ktain/GPV1/python/low_light.png

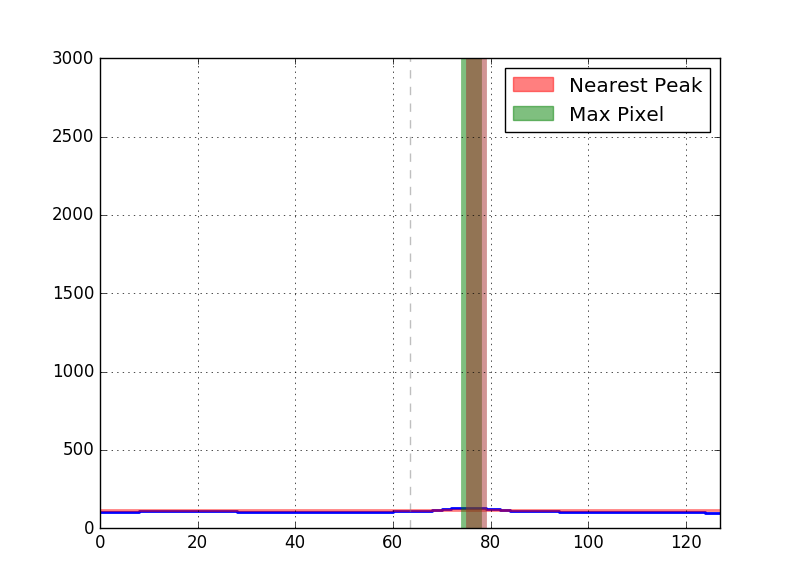
python/low_light.png
