ktain/GPV1/(threads)

Thread 3 (2017-10-20):

TODO: Implement tilt functionality for second camera.

ktain, 2017-10-20:
Remove servo panning functionality and replace with tilt functionality for second camera.

Closed 2017-10-23.

Thread 6 (2017-10-20):

TODO: Low batt indicator

ktain, 2017-10-20:
Need to check battery voltage and warn of low battery.

ktain, 2017-10-21:
Displays battery voltage upon reset.

Closed 2017-10-21.

Thread 7 (2017-10-21):

TODO: Fix camera line scanning interrupt.

ktain, 2017-10-21:
readLine() in TIM3 interrupt is blocking and preventing other interrupts from running.

ktain, 2017-10-21:
Stopped using TIM3 interrupt to read line. Moved read to systick instead.

Closed 2017-10-21.
