ktain/GPV1/eagle/GPV1.brd

## EAGLE design eagle/GPV1.brd (2017-10-25)

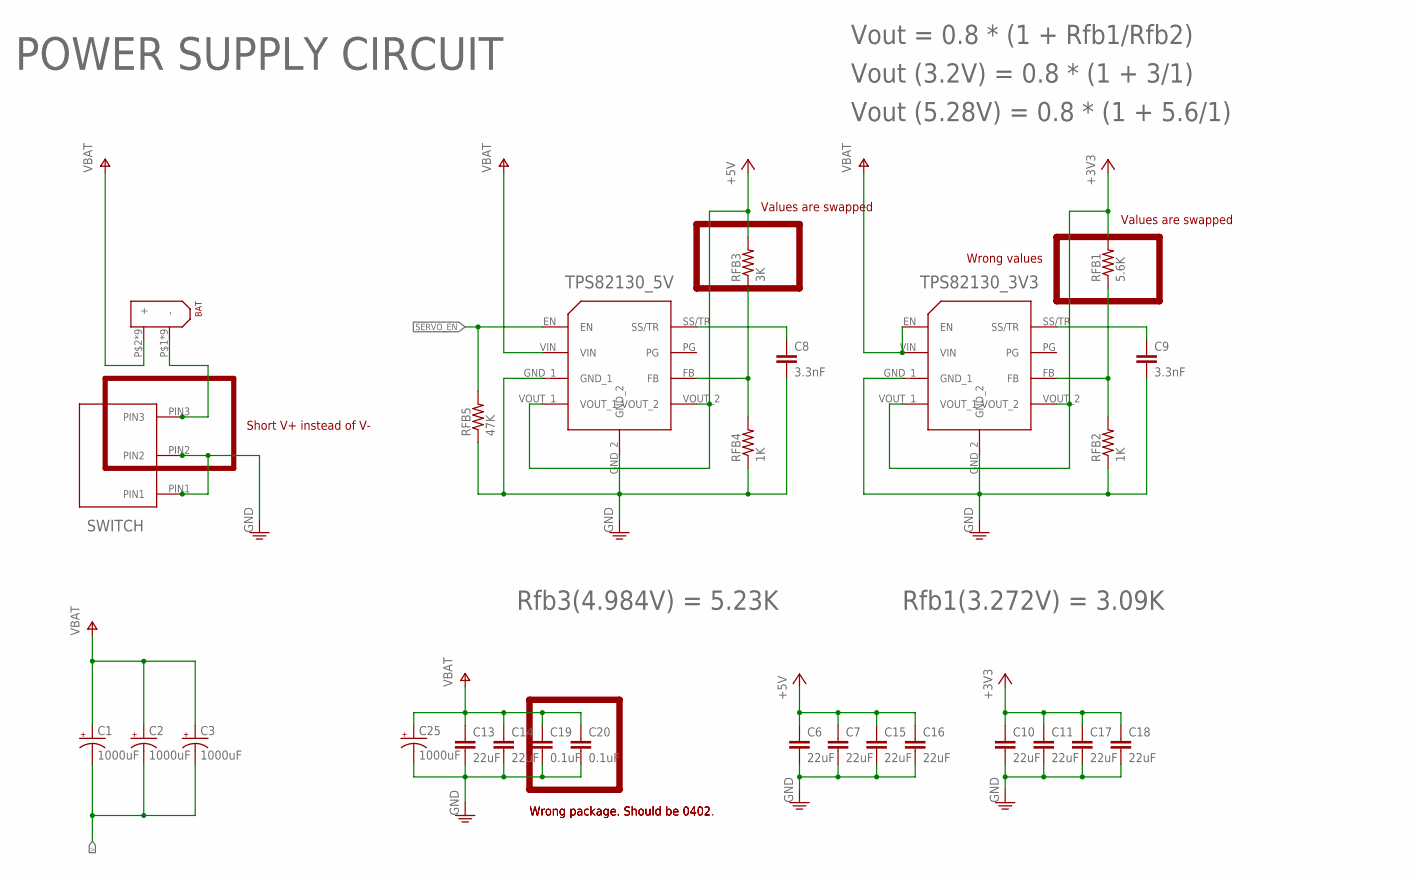
[picture p2: schematic GPV1.sch, sheet 1, Power Supply Circuit]

Parts:
BAT: XT-60
C1, C2, C3, C25: 1000uF; PANASONIC_H13
C6, C7, C10, C11, C13, C14, C15, C16, C17, C18: 22uF; 0805
C8, C9: 3.3nF; 0402-CAP
C19, C20: 0.1uF; 0805
ON<-->OFF: TS02_SWITCH
RFB1: 5.6K; 0402-RES
RFB2, RFB4: 1K; 0402-RES
RFB3: 3K; 0402-RES
RFB5: 47K; 0402-RES
TPS82130_3V3, TPS82130_5V: TPS82130

Connections:
+3V3: C10.1, C11.1, C17.1, C18.1, RFB1.2, TPS82130_3V3.VOUT_1, TPS82130_3V3.VOUT_2; also elsewhere on the board
+5V: C6.1, C7.1, C15.1, C16.1, RFB3.2, TPS82130_5V.VOUT_1, TPS82130_5V.VOUT_2; also elsewhere on the board
GND: C6.2, C7.2, C8.2, C9.2, C10.2, C11.2, C13.2, C14.2, C15.2, C16.2, C17.2, C18.2, C19.2, C20.2, C25.-, ON<-->OFF.PIN1, ON<-->OFF.PIN2, RFB2.1, RFB4.1, RFB5.1, TPS82130_3V3.GND_1, TPS82130_3V3.GND_2, TPS82130_5V.GND_1, TPS82130_5V.GND_2; also elsewhere on the board
unnamed: C9.1, TPS82130_3V3.SS/TR
unnamed: RFB1.1, RFB2.2, TPS82130_3V3.FB
unnamed: C8.1, TPS82130_5V.SS/TR
unnamed: RFB3.1, RFB4.2, TPS82130_5V.FB
SERVO_EN: RFB5.2, TPS82130_5V.EN; also elsewhere on the board
V+: BAT.P$2 (+), BAT.P$7 (+), BAT.P$8 (+), BAT.P$9 (+), BAT.P$10 (+), BAT.P$11 (+), BAT.P$12 (+), BAT.P$13 (+), BAT.P$14 (+), C1.+, C2.+, C3.+, C13.1, C14.1, C19.1, C20.1, C25.+, TPS82130_3V3.EN, TPS82130_3V3.VIN, TPS82130_5V.VIN; also elsewhere on the board
V-: BAT.P$1 (-), BAT.P$3 (-), BAT.P$4 (-), BAT.P$5 (-), BAT.P$6 (-), BAT.P$15 (-), BAT.P$16 (-), BAT.P$17 (-), BAT.P$18 (-), C1.-, C2.-, C3.-, ON<-->OFF.PIN3; also elsewhere on the board

Notes on the sheet:
POWER SUPPLY CIRCUIT
Vout = 0.8 * (1 + Rfb1/Rfb2)
Rfb3(4.984V) = 5.23K
Rfb1(3.272V) = 3.09K
Short V+ instead of V-
Wrong package. Should be 0402
Wrong values
Values are swapped
Wrong package. Should be 0402.
Vout (3.2V) = 0.8 * (1 + 3/1)
Vout (5.28V) = 0.8 * (1 + 5.6/1)

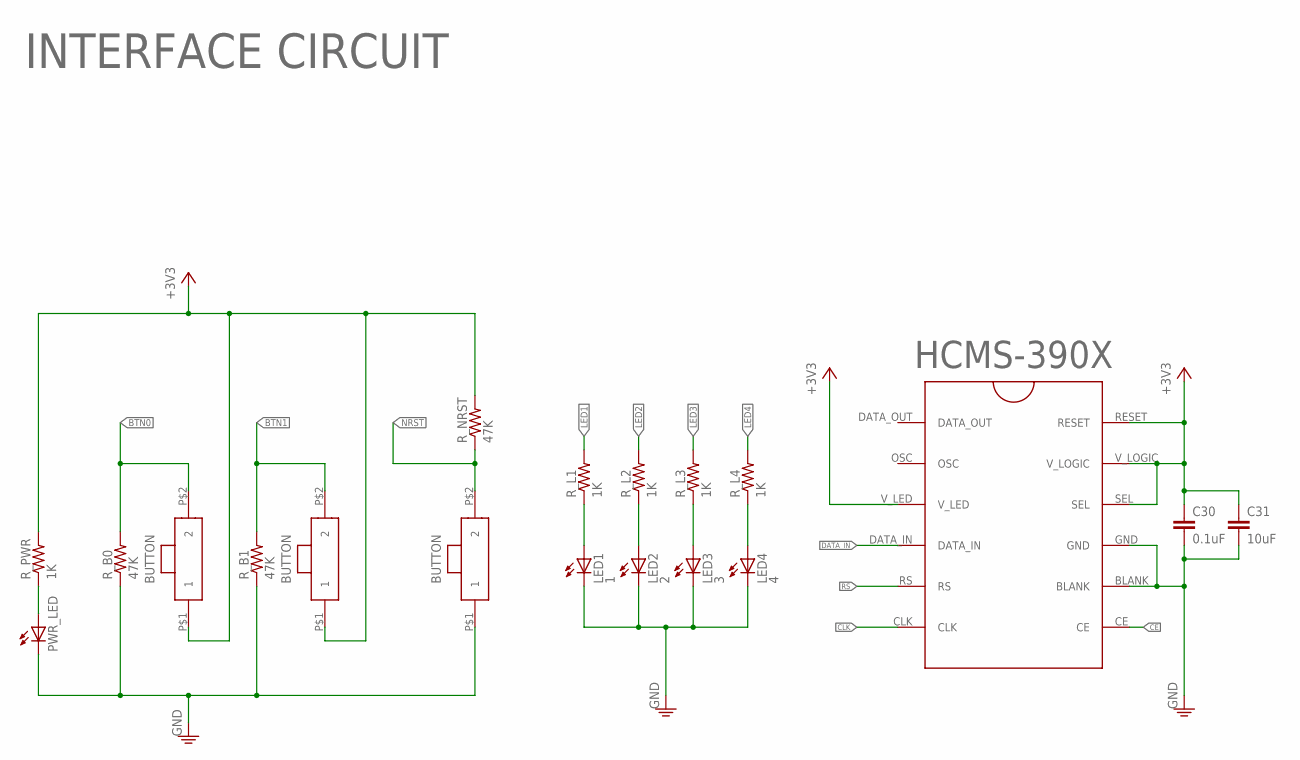
[picture p3: schematic GPV1.sch, sheet 2, Pushbuttons and LEDs]

Parts:
BTN0, BTN1: POLOLU_BUTTON
C30: 0.1uF; 0402-CAP
C31: 10uF; 0402-CAP
HCMS-390X: HCMS-390X; HCMS-2903
LED1: 1; LED-0603
LED2: 2; LED-0603
LED3: 3; LED-0603
LED4: 4; LED-0603
PWR_LED: LED0603; LED-0603
RESET: NRST; POLOLU_BUTTON
R_B0, R_B1: 47K; 0402-RES
R_L1, R_L2, R_L3, R_L4: 1K; 0402-RES
R_NRST: 47K; 0402-RES
R_PWR: 1K; 0402-RES

Connections:
+3V3: BTN0.P$1 (1), BTN1.P$1 (1), C30.1, C31.1, HCMS-390X.RESET, HCMS-390X.SEL, HCMS-390X.V_LED, HCMS-390X.V_LOGIC, R_NRST.2, R_PWR.2; also elsewhere on the board
BTN0: BTN0.P$2 (2), R_B0.2; also elsewhere on the board
BTN1: BTN1.P$2 (2), R_B1.2; also elsewhere on the board
CE: HCMS-390X.CE; also elsewhere on the board
CLK: HCMS-390X.CLK; also elsewhere on the board
DATA_IN: HCMS-390X.DATA_IN; also elsewhere on the board
GND: C30.2, C31.2, HCMS-390X.BLANK, HCMS-390X.GND, LED1.C, LED2.C, LED3.C, LED4.C, PWR_LED.C, RESET.P$1 (1), R_B0.1, R_B1.1; also elsewhere on the board
LED1: R_L1.2; also elsewhere on the board
LED2: R_L2.2; also elsewhere on the board
LED3: R_L3.2; also elsewhere on the board
LED4: R_L4.2; also elsewhere on the board
unnamed: PWR_LED.A, R_PWR.1
unnamed: LED1.A, R_L1.1
unnamed: LED2.A, R_L2.1
unnamed: LED3.A, R_L3.1
unnamed: LED4.A, R_L4.1
NRST: RESET.P$2 (2), R_NRST.1; also elsewhere on the board
RS: HCMS-390X.RS; also elsewhere on the board

Notes on the sheet:
INTERFACE CIRCUIT

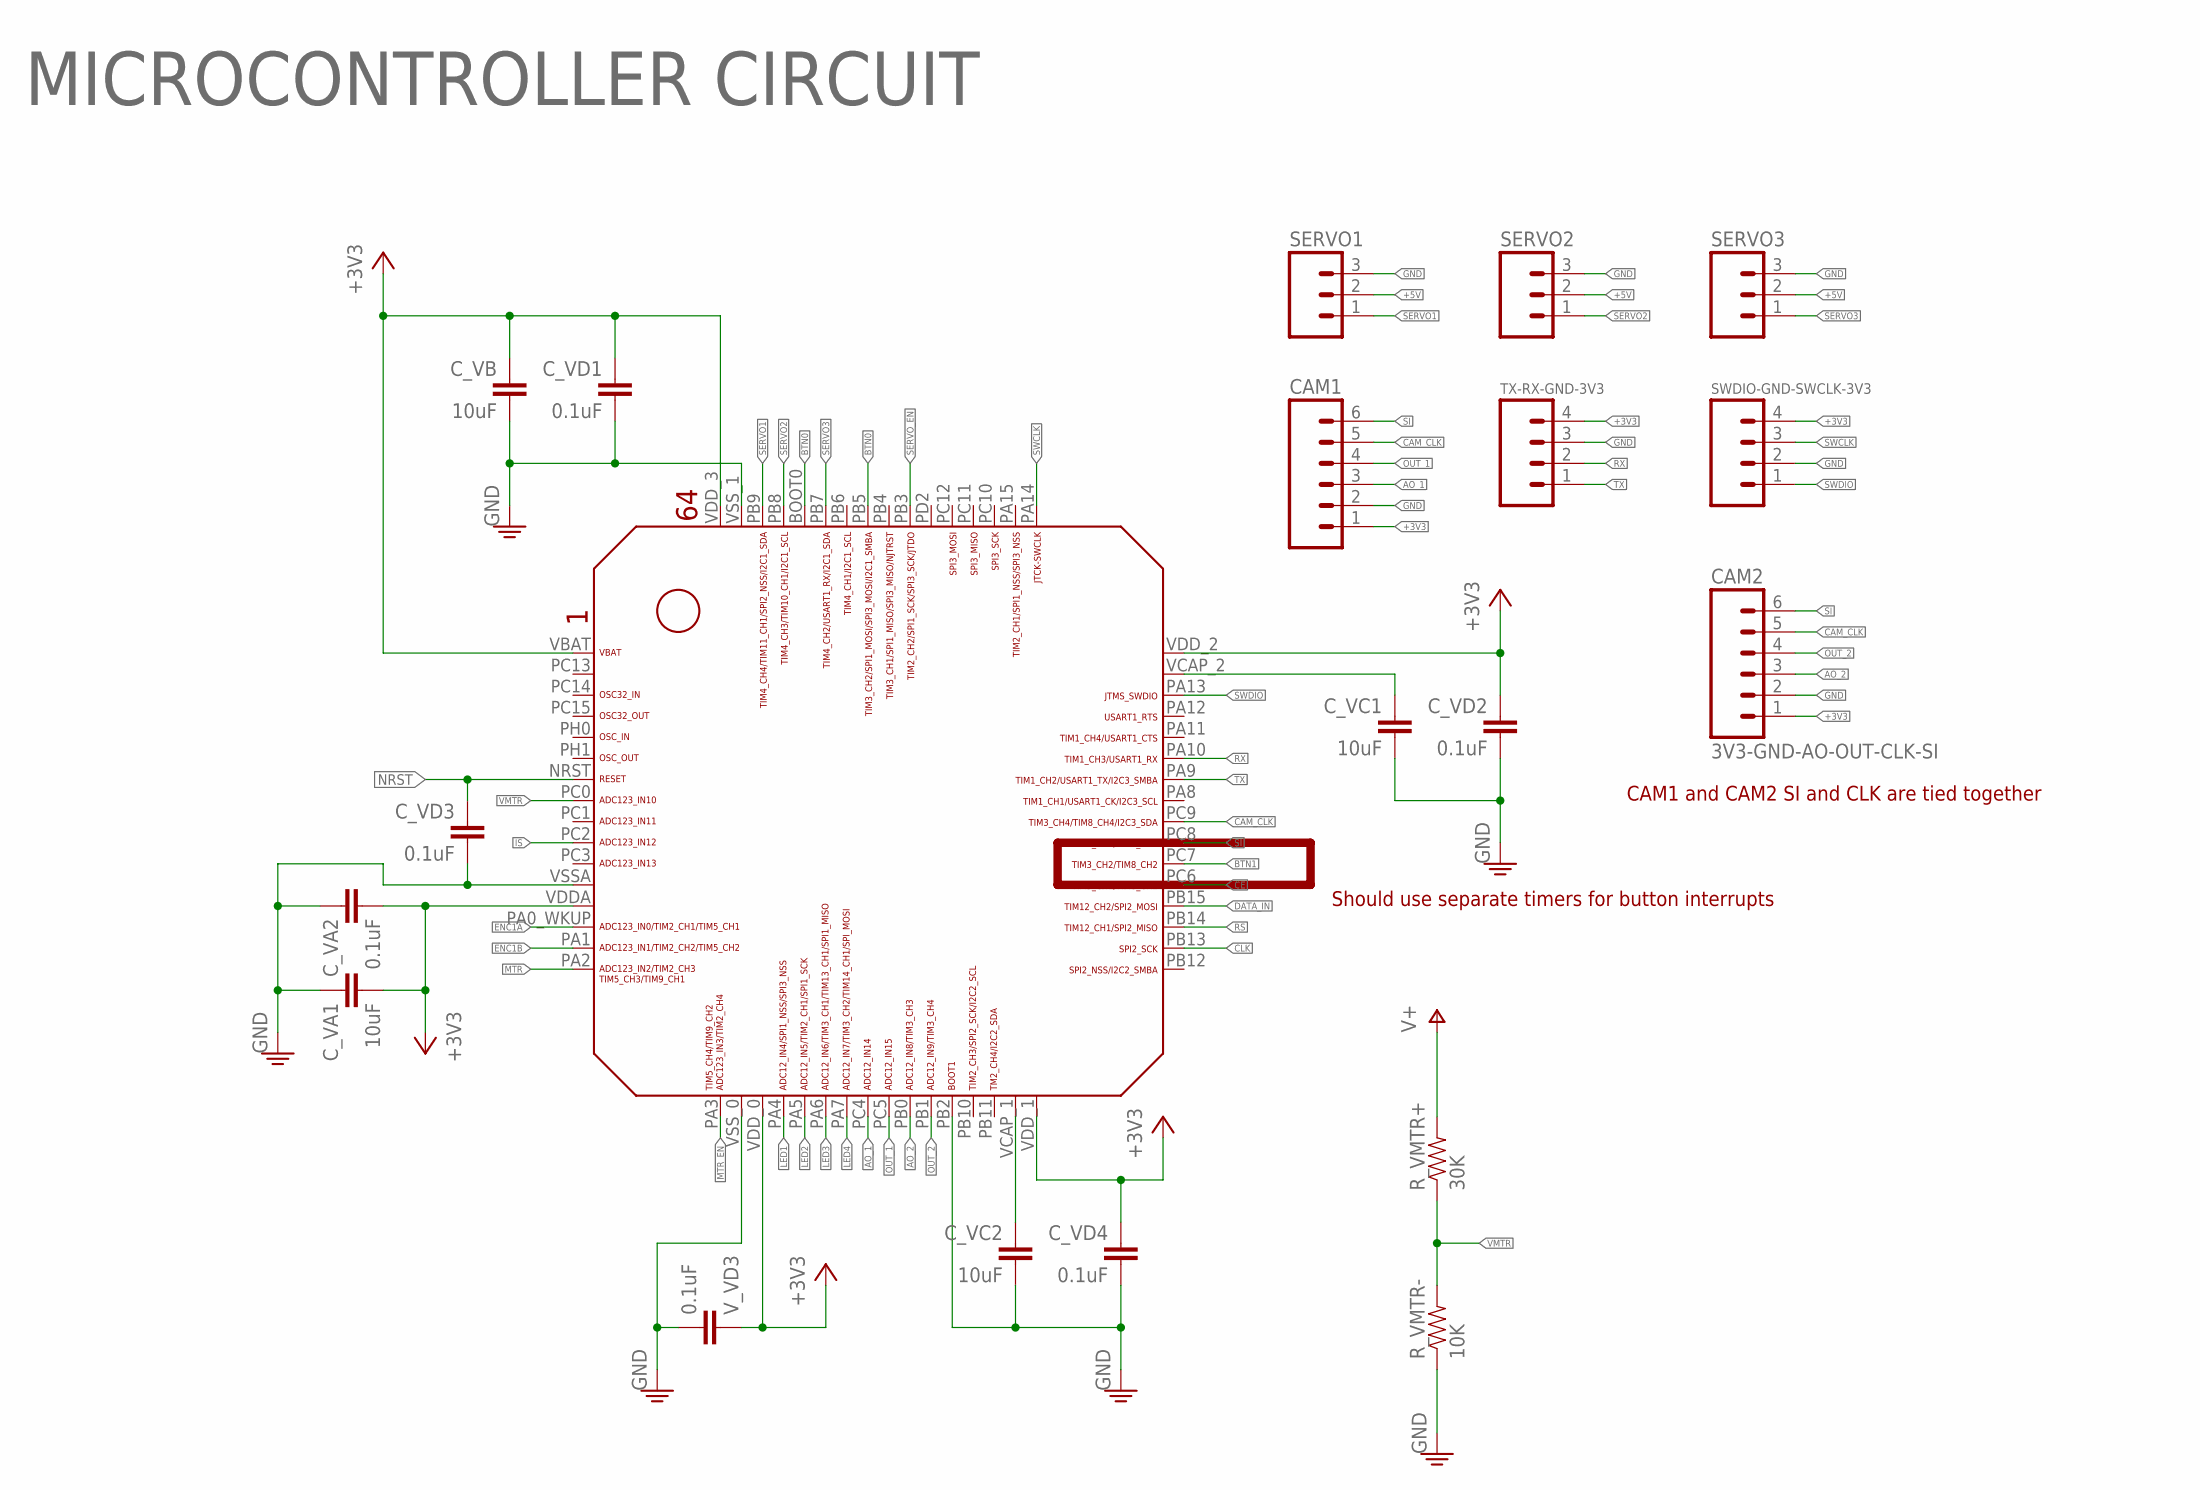
[picture p4: schematic GPV1.sch, sheet 3, Microcontroller Circuit]

Parts:
CAM1: M06SIP; 1X06
CAM2: 3V3-GND-AO-OUT-CLK-SI; 1X06
C_VA1: 10uF; 0402-CAP
C_VA2: 0.1uF; 0402-CAP
C_VB: 10uF; 0402-CAP
C_VC1, C_VC2: 10uF; 0402-CAP
C_VD1, C_VD2, C_VD3, C_VD4: 0.1uF; 0402-CAP
R_VMTR+: 30K; 0402-RES
R_VMTR-: 10K; 0402-RES
SERVO1, SERVO2, SERVO3: M03PTH; 1X03
STM32F4X5RG: STM32F405/415_LQFP64
SWDIO-GND-SWCLK-3V3: M04PTH; 1X04
TX-RX-GND-3V3: M04PTH; 1X04
V_VD3: 0.1uF; 0402-CAP

Connections:
+3V3: CAM1.1, CAM2.1, C_VA1.2, C_VA2.2, C_VB.1, C_VD1.1, C_VD2.1, C_VD4.1, STM32F4X5RG.VBAT, STM32F4X5RG.VDDA, STM32F4X5RG.VDD_0, STM32F4X5RG.VDD_1, STM32F4X5RG.VDD_2, STM32F4X5RG.VDD_3, SWDIO-GND-SWCLK-3V3.4, TX-RX-GND-3V3.4, V_VD3.1; also elsewhere on the board
+5V: SERVO1.2, SERVO2.2, SERVO3.2; also elsewhere on the board
AO_1: CAM1.3, STM32F4X5RG.PC4
AO_2: CAM2.3, STM32F4X5RG.PB0
BTN0: STM32F4X5RG.BOOT0, STM32F4X5RG.PB5; also elsewhere on the board
BTN1: STM32F4X5RG.PC7; also elsewhere on the board
CAM_CLK: CAM1.5, CAM2.5, STM32F4X5RG.PC9
CE: STM32F4X5RG.PC6; also elsewhere on the board
CLK: STM32F4X5RG.PB13; also elsewhere on the board
DATA_IN: STM32F4X5RG.PB15; also elsewhere on the board
ENC1A: STM32F4X5RG.PA0_WKUP (PA0_AKUP); also elsewhere on the board
ENC1B: STM32F4X5RG.PA1; also elsewhere on the board
GND: CAM1.2, CAM2.2, C_VA1.1, C_VA2.1, C_VB.2, C_VC1.2, C_VC2.2, C_VD1.2, C_VD2.2, C_VD3.2, C_VD4.2, R_VMTR-.1, SERVO1.3, SERVO2.3, SERVO3.3, STM32F4X5RG.PB2, STM32F4X5RG.VSSA, STM32F4X5RG.VSS_0, STM32F4X5RG.VSS_1, SWDIO-GND-SWCLK-3V3.2, TX-RX-GND-3V3.3, V_VD3.2; also elsewhere on the board
IS: STM32F4X5RG.PC2; also elsewhere on the board
LED1: STM32F4X5RG.PA4; also elsewhere on the board
LED2: STM32F4X5RG.PA5; also elsewhere on the board
LED3: STM32F4X5RG.PA6; also elsewhere on the board
LED4: STM32F4X5RG.PA7; also elsewhere on the board
MTR: STM32F4X5RG.PA2; also elsewhere on the board
MTR_EN: STM32F4X5RG.PA3; also elsewhere on the board
unnamed: C_VC2.1, STM32F4X5RG.VCAP_1
unnamed: C_VC1.1, STM32F4X5RG.VCAP_2
NRST: C_VD3.1, STM32F4X5RG.NRST; also elsewhere on the board
OUT_1: CAM1.4, STM32F4X5RG.PC5
OUT_2: CAM2.4, STM32F4X5RG.PB1
RS: STM32F4X5RG.PB14; also elsewhere on the board
RX: STM32F4X5RG.PA10, TX-RX-GND-3V3.2
SERVO1: SERVO1.1, STM32F4X5RG.PB9
SERVO2: SERVO2.1, STM32F4X5RG.PB8
SERVO3: SERVO3.1, STM32F4X5RG.PB7
SERVO_EN: STM32F4X5RG.PB3; also elsewhere on the board
SI: CAM1.6, CAM2.6, STM32F4X5RG.PC8
SWCLK: STM32F4X5RG.PA14, SWDIO-GND-SWCLK-3V3.3
SWDIO: STM32F4X5RG.PA13, SWDIO-GND-SWCLK-3V3.1
TX: STM32F4X5RG.PA9, TX-RX-GND-3V3.1
V+: R_VMTR+.2; also elsewhere on the board
VMTR: R_VMTR+.1, R_VMTR-.2, STM32F4X5RG.PC0

Notes on the sheet:
MICROCONTROLLER CIRCUIT
Should use separate timers for button interrupts
CAM1 and CAM2 SI and CLK are tied together

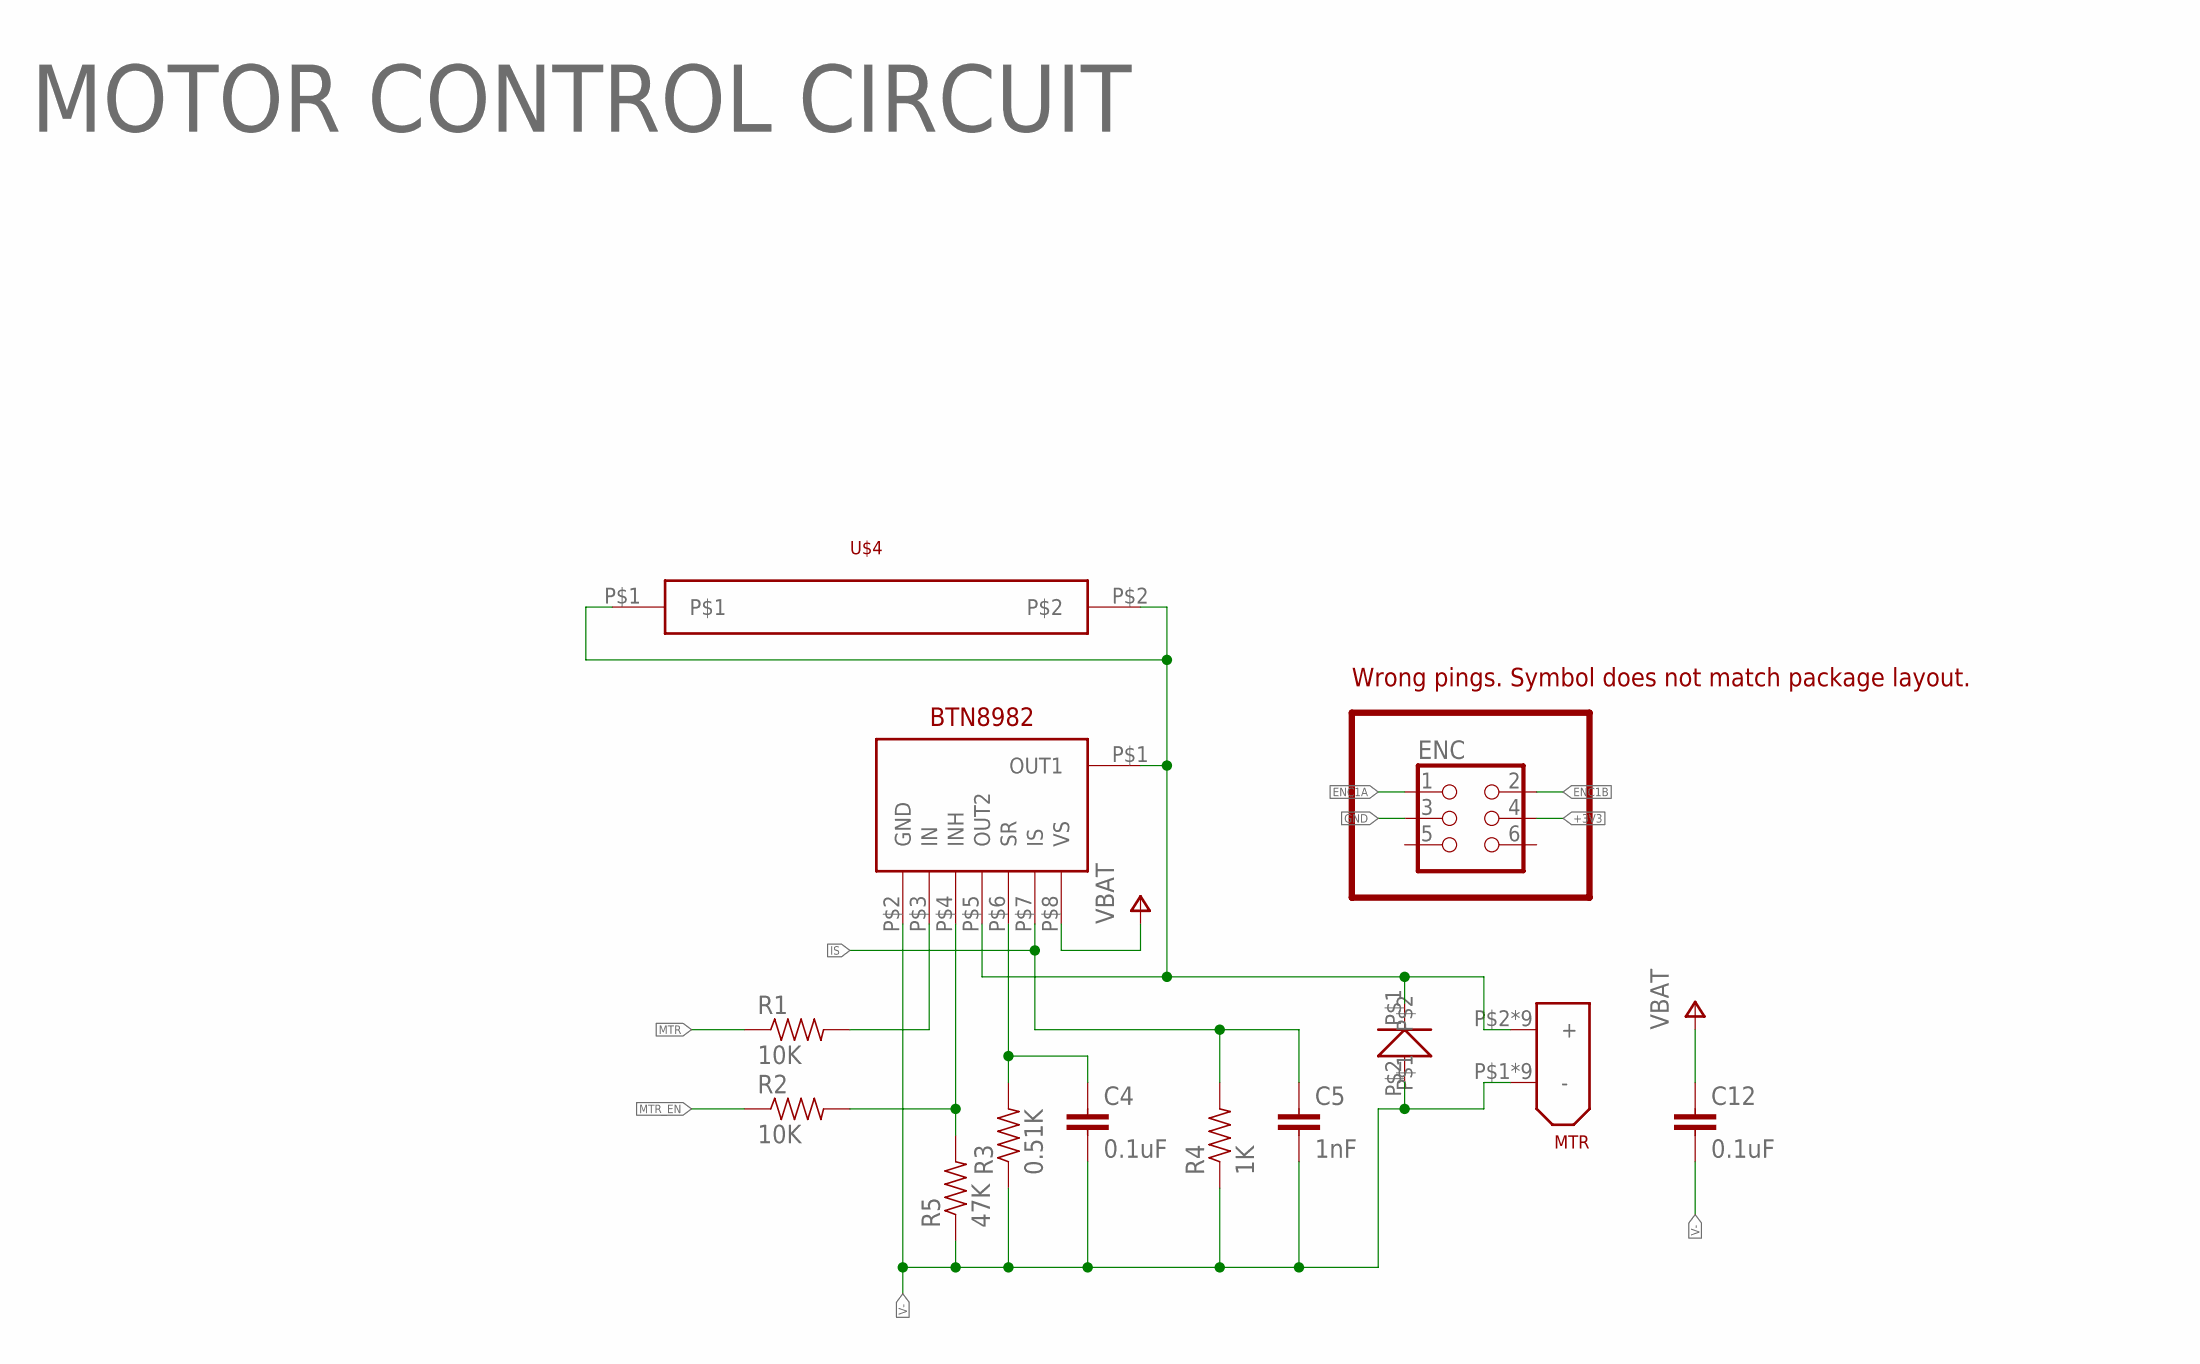
[picture p5: schematic GPV1.sch, sheet 4, Motor Control Circuit]

Parts:
BTN8982: BTN8982
C4, C12: 0.1uF; 0402-CAP
C5: 1nF; 0402-CAP
DIODE: DIODE_DO-214AB; DO-214AB
ENC: PINHD-2X31; DIN-41651
MTR: XT-60
R1, R2: 10K; 0402-RES
R3: 0.51K; 0402-RES
R4: 1K; 0402-RES
R5: 47K; 0402-RES
U$4: HEATSINK_TO-263

Connections:
+3V3: ENC.4; also elsewhere on the board
ENC1A: ENC.1; also elsewhere on the board
ENC1B: ENC.2; also elsewhere on the board
GND: ENC.3; also elsewhere on the board
IS: BTN8982.P$7 (IS), C5.1, R4.2; also elsewhere on the board
MTR: R1.1; also elsewhere on the board
MTR_EN: R2.1; also elsewhere on the board
unnamed: BTN8982.P$3 (IN), R1.2
unnamed: BTN8982.P$4 (INH), R2.2, R5.2
unnamed: BTN8982.P$6 (SR), C4.1, R3.2
unnamed: BTN8982.P$1 (OUT1), BTN8982.P$5 (OUT2), DIODE.P$1, MTR.P$2 (+), MTR.P$7 (+), MTR.P$8 (+), MTR.P$9 (+), MTR.P$10 (+), MTR.P$11 (+), MTR.P$12 (+), MTR.P$13 (+), MTR.P$14 (+), U$4.P$1, U$4.P$2
V+: BTN8982.P$8 (VS), C12.1; also elsewhere on the board
V-: BTN8982.P$2 (GND), C4.2, C5.2, C12.2, DIODE.P$2, MTR.P$1 (-), MTR.P$3 (-), MTR.P$4 (-), MTR.P$5 (-), MTR.P$6 (-), MTR.P$15 (-), MTR.P$16 (-), MTR.P$17 (-), MTR.P$18 (-), R3.1, R4.1, R5.1; also elsewhere on the board

Notes on the sheet:
MOTOR CONTROL CIRCUIT
Wrong pings. Symbol does not match package layout.

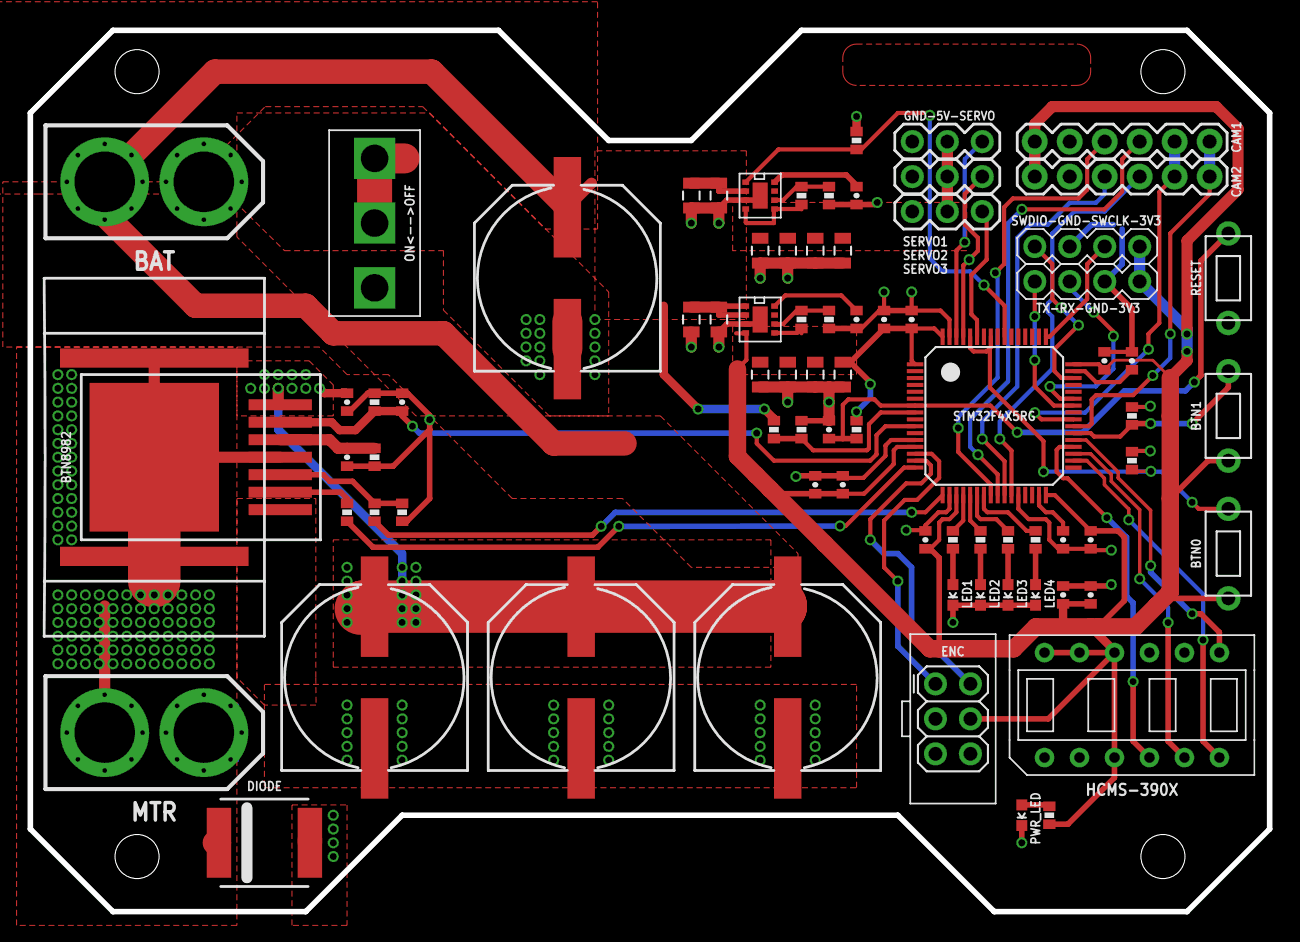
[picture p6: board GPV1.brd from above]

Board: 2 copper layers, 90.0 x 64.0 mm, 79 parts (0 on the bottom side), 51 nets.
