ktain/GPV1/user_inc/menu.h

#if !defined(MENU_H)
#define MENU_H

extern bool busy;
extern bool isRunning;
extern int32_t numOptions;
extern int32_t menuEncCount;
extern int32_t ticksPerOption;

void refreshOptions(void);
void enter(void);

extern char* options[];

#endif
