ktain/GPV1/(commit log)

2017-10-20 Initial commit. Most setup routines done. Speed control, servos, camera working.
2017-10-21 Implemented display functionality. Fixed static text bug.
    [camera.c, display.c, display.h, main.c, setup.c, setup.h, userconfig.c]
2017-10-21 Disabled timer_setup()
2017-10-22 Implemented preliminary kill switch functionality in systick
2017-10-23 Renamed camera variables
2017-10-23 Implemented spatial moving average filter
2017-10-25 Added eagle board and schematic
    [GPV1.brd, GPV1.sch]
2017-10-25 Corrected feedback resistor notes in schematic.
    [GPV1.sch]
2017-10-26 Fixed nearest peak relative to old position (python). Added max line width.
    [detectline.py]
2017-10-27 Fixed nearest peak detection.
    [camera.c, main.c]
2017-10-27 Refactored steering code. Adjustable servo period.
2017-10-27 Modified getNearestPeak for floating point operation. Servos stable at 3000us (333Hz)
2017-10-30 Camera read routine moved to TIM3 interrupt
2017-10-30 Changed camera read order to STOP->RESTART->SAVE
2017-10-30 Steering PD implemented
2018-05-03 Fixed display with less than 4 characters
    [camera.c, display.c, main.c, menu.c, menu.h, motorcontrol.c, userconfig.c]
2018-05-03 Added speed profiles and adjustable camera tilt angle to menu
